soumyajitsahoo-cell/myuko/JOURNAL.md

---
title: "Myuko"
github: "https://github.com/soumyajitsahoo-cell/uncanny-cobweb"
description: "A custom made, music player, based on my own preferences. Listening to music with my long-screen phone just doesn't do it. I want a better experience, and I can't simply buy a music player because IT IS EXPENSIVE. I intend to have it run on android, with touchscreen support, and perhaps even finding songs like google does just with the sound of the song."
created_at: "2026-11-01"
total_time: "14h 24m"
---

# November 1, 2026: First Day, Brainstorming
<!-- fabricate:entry 1804 -->

I created my project in Fabricate. 
I really don't know where to start, so I'm still figuring it out
What I intend to make is quite difficult, to be honest
But with some research, I think i can do it
Today is my first day, I'll research the night to get a good grasp before starting in a non-directiona way



**Total time spent: 6m**

# November 2, 2026: Understood My Requirements and started designing
<!-- fabricate:entry 1835 -->

So, building a android-based music player and building the whole system seemed a bit unrealistic and a difficult achievement, so I'm lowering, just a bit. So, first, watched based music player. Aux support and Bluetooth, and runs via SD card. 
From what I researched, the Ingenious X1000E is a processor specifically for making music player(implemented in many market products) and using that is the best option so far. 
With that at it's center, I started designing the PCB designing, the core.
I haven't finished it(yet), and I'm working on it locally, not yet pushing to the git repo. Firstly it took me time to understand what I need to do, now I'm getting started at it

KiCad doesn't have the X1000E in-built in it's library, and I couldn't get it from EasyEDA because it had  a paywall in JLCPCB . Instead of paying or signing up for trials, I dug into the open-source community, extracted the official 190-ball BGA footprint (BGA-190_0.8mm) and schematic symbols, and manually injected them directly into my local KiCad project. Now, here is what I have done so far 
1]Connected a quartz crystal across pins R10 (EXCLK_XO) and T10 (EXCLK_XI) with two balanced 12pF load capacitors to ground.
2]an active-low reset on pin P6 (PPRST_) using a 10 kΩ pull-up resistor to +3V3 and a push-button to GND
3]tied the internal PLL analog and digital supplies (PLL_AVDD and PLL_DVDD) to a dedicated +1V2 rail, and anchored PLL_AVSS/PLL_DVSS to GND
4]Connected a 16MB Operating System Flash (W25Q128JVS), backed by a 0.1uF coupling capacitor
5] connected a 32-bit/384kHz DAC (TI PCM5102A) to the X1000E. Connections:
a) SA1_I2S_BCLK connected to Pin 13
b) SA2_I2S_LRCLK connected to Pin 15
c) SA4_I2S_DO connected Pin 14
Two hours in, the CPU core, system clock, OS memory bus, and the digital half of the audio subsystem are completely wired.
Next Steps:
1)Finish the PCM5102A analog filtering and 3.5mm Aux jack.
2)Add the MicroSD slot (where the FLAC/MP3 files will be stored).
3)Design the battery charging circuit (USB-C + PMIC).
4)Break out the display ribbon connector for the 1.28" circular screen.
Here are some screenshots from KiCad:




**Total time spent: 3h**

# November 3, 2026: Connected Headphone Jack,MicroSD Port, Processor Boot Config
<!-- fabricate:entry 2081 -->

So, in my last journal, I got started with the PCB design. Since then, I have made some progress(not much since I'm also busy with my classes). Here's what I did after my last journal
1] Completed the analog output stage of PCM5102A DAC and wired it to a 3.5mm Headphone Jack(I'm not mention the complete connections, but instead I'm providing screenshots so I don't have to type so much)(Wires were crossed between the DAC pins and the resistors to compensate for KiCad's jack symbol placing R above T, ensuring proper left/right stereo imaging in headphones.)
2] Connected Micro_SD_Card_Det(the symbol name) (Placed a No-Connect flag on Pin 9 to denote intentional floating card-detect switch without generating ERC warnings.)
3]Configured the Ingenic X1000E's internal bootloader state machine so that upon reset release, the processor fetches U-Boot and the Linux kernel directly from the external 16MB Flash (W25Q128JVS)

Next Steps: Connecting 1.28" Round Display. 
Below are images of my progress so far






I will upload the sch file once I'm done with it, I'm getting busy with the tests and classes that are happening. Once the weekend arrives, I'll sync my local folder to the project

**Total time spent: 2h 6m**

# November 7, 2026: Touch Display and USB C-Port Connection
<!-- fabricate:entry 2359 -->

So my streak is gone now, was busy with classes and labs, and Today I went to the theatres for a movie(it was absolutely fun and tiring too). Anyway, since my last journal, here are the changes I have made so far(screenshots will also be provided
below)
1]Display and Touch - Placed a 12-pin ribbon connector right above the MicroSD socket.
Powered the display logic and LED backlight with +3V3 and GND.
Connected all 5 picture lines directly to the top pins of the processor (U1).
Attached 4 touch name tags (TP_INT, TP_SDA, TP_SCL, TP_RST) so you can tap and swipe without running messy wires across the sheet.
2] USB-C port - Added the modern 16-pin USB-C receptacle.
Grounded the metal shell and ground pins to GND.
Added two independent 5.1kΩ resistors on CC1 and CC2 so smart USB-C chargers (like Apple or Anker) recognize the watch and provide 5V.
Labeled the incoming 5V line VBUS.
3] Battery Subsystem - Placed the MCP73831 charger chip powered by 5V VBUS with a 
4.7𝜇F smoothing capacitor.
Added a 4.7kΩ programming resistor (R8) to set a safe, gentle 212mA charging speed so the watch stays cool on your wrist.
Added a 2-pin battery plug (J5) and connected it to the master VBAT line.
4] Other - U5 (3.3V): Creates clean +3V3 for the screen, flash storage, SD card, and audio chip.
U6 (1.8V): Creates clean +1V8 for the brain's internal 64MB RAM.
U7 (1.2V): Creates clean +1V2 for the main CPU thinking engine.
Each regulator has its own input (1.0 μF) and output (2.2 μF) filter capacitors to keep voltages rock solid.
CPU Core: 8 pins of VDD wired together to +1V2.
Main Ground: 11 pins of VSS wired together to GND.
I/O Power: 4 pins of VDDIO wired together to +3V3.
RAM Memory Power: 6 pins of VSSMEM grounded; 6 pins of VDDMEM fed +1V8.
RAM Tuning Helpers: Added 0.1 μF capacitor (C15) on VREF0 and a precision 240Ω resistor (R9) on ZQ.
RAM Buffers & Core: 8 pins of LPDDR_VSS/Q tied to GND; 8 pins of LPDDR_VDD/Q tied to +1V8.
Unused JTAG Pins: Terminated 6 factory test pins at the bottom corner with blue X (No-Connect) flags.
Internal Codec: Powered its digital rails with +1V8 & GND, and marked all unused mic and speaker pins with blue X flags.

All the screenshots are given below




**Total time spent: 4h**

# November 9, 2026: Completed the PCB
<!-- fabricate:entry 2503 -->

Firstly, A late Happy Diwali to Everyone who is celebrating and knows about the festival. Stayed Eco-friendly, as I should, and had a lot of fun in the past few days. Today's the time to celebrate. 

With the help of my senior friend, Anshuman Pati, I was able to get my pcb design completed from the schematic I built( Basically he helped me get my PCB done from my schematic, huge thanks to him).

Now, the PCB is set to fit for a circular case of 23mm diameter, and is arranged properly. I'm going to update this repository and upload the files and bill of materials.

Screenshots of the 3D model of the PCB is given below. And By Today, or tomorrow, I will put everything in the repository, and take my time for building a readme.txt file. I'm on a clock now, since I have roughly 10-11 days to complete the whole thing and send a design review to get resources to build it

So excited for this, really. (Still haven't started with designing the UI :| )







**Total time spent: 5h 12m**
