soumyajitsahoo-cell/myuko/production/myuko_iso_3d.png

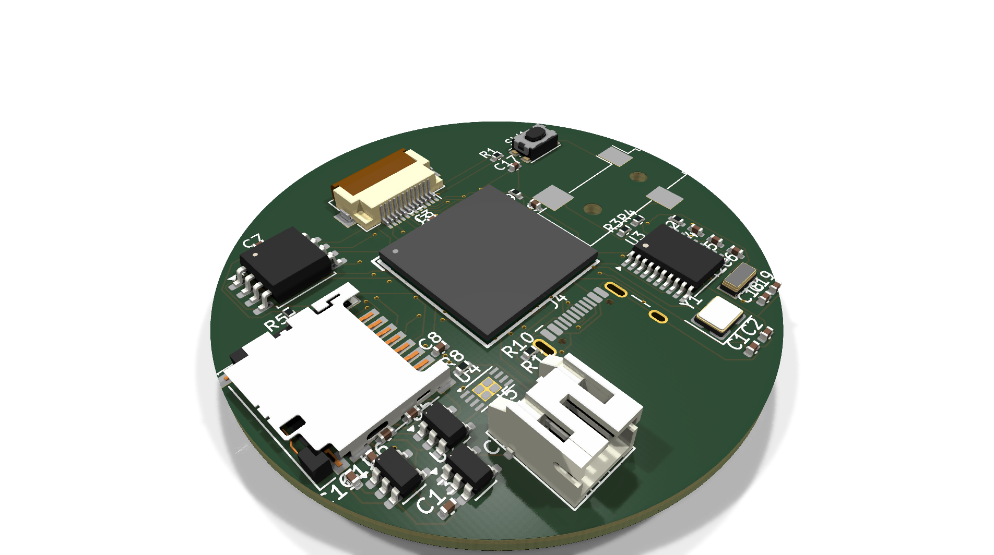
production/myuko_iso_3d.png
