soumyajitsahoo-cell/myuko/production/myuko_top_3d.png

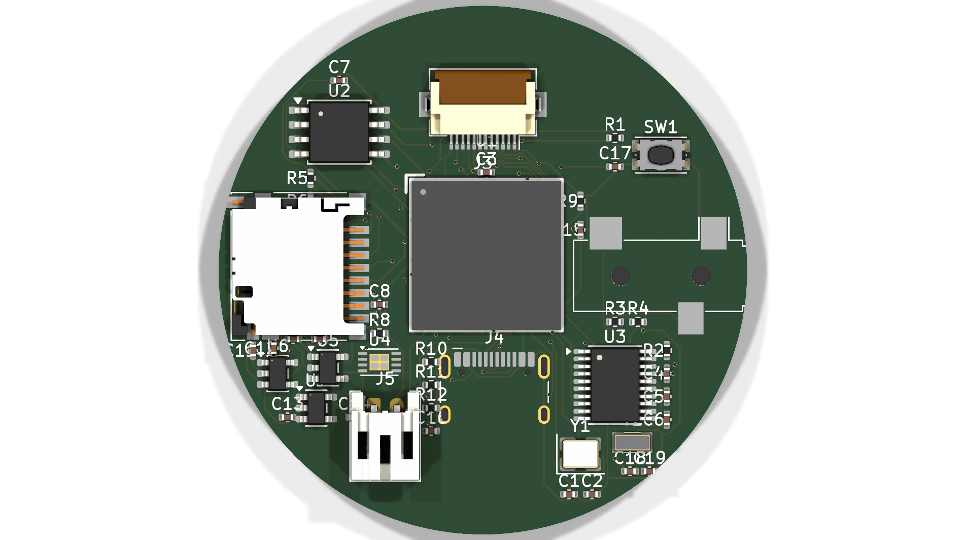
production/myuko_top_3d.png
