soumyajitsahoo-cell/myuko/production/watch_case/myuko_watch_all_black_iso.png

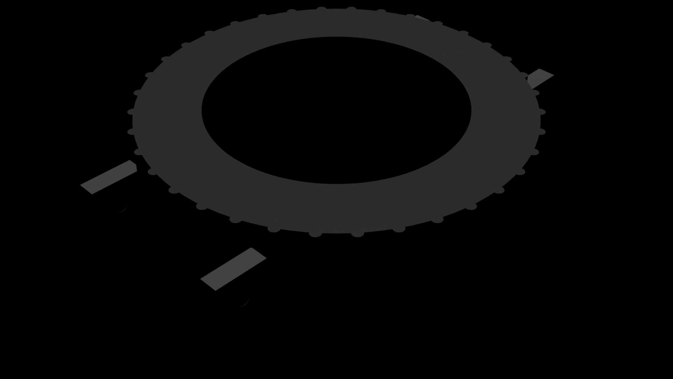
production/watch_case/myuko_watch_all_black_iso.png
