soumyajitsahoo-cell/myuko/production/watch_case/myuko_watch_all_black_top.png

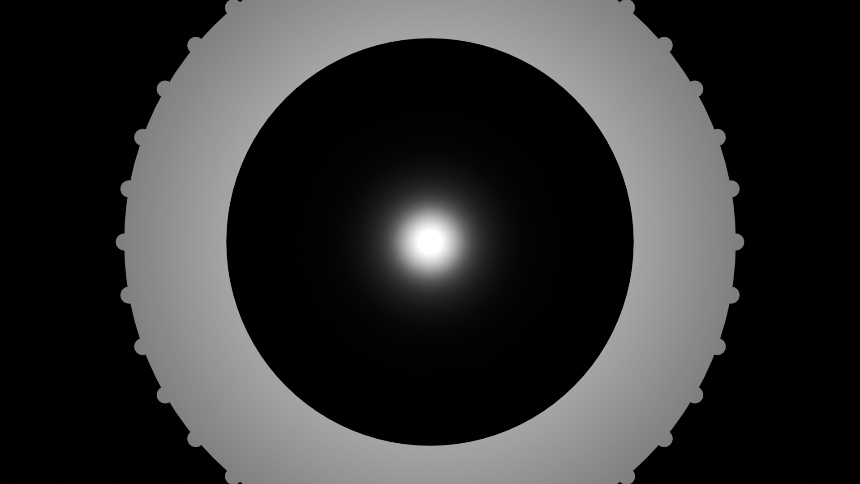
production/watch_case/myuko_watch_all_black_top.png
