soumyajitsahoo-cell/myuko/BOM.csv

Part | Type | Quantity | Unit price (USD) | Line total (USD) | Link | Vendor | Funding | Notes | Designator
Ingenic X1000E MIPS 1GHz CPU (64MB LPDDR) | Part | 1 | 5.80 | 5.80 | https://www.lcsc.com/product-detail/Microcontroller-Units-MCUs-MPUs-SOCs_Ingenic-Semicon-X1000E_C2689394.html | LCSC | Grant |  | U1
Winbond 16MB SPI NOR Flash (W25Q128) | Part | 1 | 0.85 | 0.85 | https://www.lcsc.com/product-detail/NOR-FLASH_Winbond-Elec-W25Q128JVSIQ_C97521.html | LCSC | Grant |  | U2
TI PCM5102APWR 32-bit 384kHz Audio DAC | Part | 1 | 2.10 | 2.10 | https://www.lcsc.com/product-detail/Audio-Power-OpAmps_Texas-Instruments-PCM5102APWR_C107671.html | LCSC | Grant |  | U3
Microchip MCP73831T Li-Po Charge IC | Part | 1 | 0.35 | 0.35 | https://www.lcsc.com/product-detail/Battery-Management-ICs_Microchip-Tech-MCP73831T-2ACI-MC_C49774.html | LCSC | Grant |  | U4
Diodes Inc AP2112K LDO Regulators (3.3V 1.8V 1.2V) | Part | 3 | 0.23 | 0.68 | https://www.lcsc.com/product-detail/Linear-Voltage-Regulators-LDO_Diodes-Incorporated-AP2112K-3-3TRG1_C51118.html | LCSC | Grant |  | U5 U6 U7
3.5mm Stereo Headphone Socket (SJ-3523-SMT) | Part | 1 | 0.25 | 0.25 | https://www.lcsc.com/product-detail/Audio-Connectors_CUI-Devices-SJ-3523-SMT-TR_C4991872.html | LCSC | Grant |  | J1
MicroSD Card Push-Push Push-Pull Socket | Part | 1 | 0.32 | 0.32 | https://www.lcsc.com/product-detail/Card-Sockets-Connectors_SOFNG-TF-01A_C2932349.html | LCSC | Grant |  | J2
FPC 0.5mm 12-Pin Top-Contact SMD Socket | Part | 1 | 0.18 | 0.18 | https://www.lcsc.com/product-detail/FFC-FPC-Connectors_JUSHUO-FPC0520HB-12P_C262657.html | LCSC | Grant |  | J3
USB Type-C 16-Pin Receptacle (USB 2.0 SMT) | Part | 1 | 0.28 | 0.28 | https://www.lcsc.com/product-detail/USB-Connectors_HOO-R-TYPE-C-16PIN-2MD-073_C2765186.html | LCSC | Grant |  | J4
JST-PH 2.0mm 2-Pin SMD Terminal | Part | 1 | 0.05 | 0.05 | https://www.lcsc.com/product-detail/Pluggable-System-Terminal-Block_JST-Sales-America-B2B-PH-K-S-LF-SN_C131337.html | LCSC | Grant |  | J5
Side SMD Tactile Switch 3x2.5mm | Part | 1 | 0.08 | 0.08 | https://www.lcsc.com/product-detail/Tactile-Switches_XKB-Enterprise-TS-1088R-02526_C2844781.html | LCSC | Grant |  | SW1
24MHz Main & 32.768kHz RTC Crystals (SMD 3225) | Part | 2 | 0.12 | 0.23 | https://www.lcsc.com/product-detail/Crystals_YXC-Yangxing-Tech-X322524MOB4SI_C70590.html | LCSC | Grant |  | Y1 Y2
0402 Ceramic Capacitors & Resistors (Assorted) | Part | 31 | 0.005 | 0.16 | https://www.lcsc.com/product-detail/Multilayer-Ceramic-Capacitors-MLCC-SMD-SMT_YAGEO-CC0402JRNPO9BN120_C1547.html | LCSC | Grant |  | C1-C19 R1-R12
1.28 inch Round IPS Touchscreen (GC9A01 + CST816S) | Part | 1 | 4.80 | 4.80 | https://www.waveshare.com/1.28inch-touch-lcd.htm | Waveshare Store | Grant |  | DISP1
3.7V 400mAh Li-Po Rechargeable Pouch Cell (502530) | Part | 1 | 3.50 | 3.50 | https://www.adafruit.com/product/1578 | Adafruit / Makerfabs | Grant |  | BAT1
20mm Quick-Release Black Silicone Sport Band | Part | 1 | 2.50 | 2.50 | https://www.amazon.com/dp/B07F2BF25S | Amazon / Retail | Grant |  | STRAP1
Custom 4-Layer Circular PCB (x5 boards fab cost) | PCB | 5 | 2.00 | 10.00 | https://jlcpcb.com | JLCPCB | Grant |  | PCB
4-Part Matte Black Nylon MJF Enclosure | 3D printed | 1 | 4.50 | 4.50 | https://jlcpcb.com/3d-printing | JLCPCB 3D Printing | Grant |  | CASE
Total |  |  |  | 36.63
