soumyajitsahoo-cell/myuko/production/bom_jlcpcb.csv

Comment | Designator | Footprint | LCSC Part #
12pF | C1,C2 | C_0402_1005Metric | C1547
0.1uF | C3,C5,C7,C15 | C_0402_1005Metric | C1525
2.2uF | C4,C6,C10,C12,C14 | C_0402_1005Metric | C23630
4.7uF | C8 | C_0402_1005Metric | C23633
1uF | C9,C11,C13,C16 | C_0402_1005Metric | C52923
1nF | C17 | C_0402_1005Metric | C1523
15pF | C18,C19 | C_0402_1005Metric | C1550
AudioJack3_Ground_Switch | J1 | Jack_3.5mm_CUI_SJ-3523-SMT_Horizontal | C4991872
Micro_SD_Card_Det1 | J2 | microSD_HC_Hirose_DM3D-SF | C381082
Conn_01x12_Pin | J3 | Hirose_FH12-12S-0.5SH_1x12-1MP_P0.50mm_Horizontal | C262661
USB_C_Receptacle_USB2.0_16P | J4 | USB_C_Receptacle_HCTL_HC-TYPE-C-16P-01A | C2765186
Conn_01x02_Pin | J5 | JST_PH_S2B-PH-K_1x02_P2.00mm_Horizontal | C131337
10k | R1,R2,R5,R6,R7 | R_0402_1005Metric | C25744
470 | R3,R4 | R_0402_1005Metric | C25117
4.7k | R8 | R_0402_1005Metric | C25900
240 | R9 | R_0402_1005Metric | C25091
5.1k | R10,R11 | R_0402_1005Metric | C25905
43.2 | R12 | R_0402_1005Metric | C25121
SW_Push | SW1 | SW_Push_1P1T_NO_CK_KMR2 | C318884
X1000 | U1 | BGA-190_L13.0-W13.0-R16-C16-P0.8-TR | C2689394
W25Q128JVS | U2 | SOIC-8_5.3x5.3mm_P1.27mm | C97521
PCM5102A | U3 | TSSOP-20_4.4x6.5mm_P0.65mm | C107671
MCP73831-2-MC | U4 | DFN-8-1EP_3x2mm_P0.5mm_EP1.7x1.4mm | C49774
AP2112K-3.3 | U5 | SOT-23-5 | C51118
AP2112K-1.8 | U6 | SOT-23-5 | C176944
AP2112K-1.2 | U7 | SOT-23-5 | C460310
Crystal | Y1 | Crystal_SMD_3225-4Pin_3.2x2.5mm | C70590
32.768kHz | Y2 | Crystal_SMD_3215-2Pin_3.2x1.5mm | C32346
