soumyajitsahoo-cell/myuko/production/watch_case/myuko_case_main_chassis.stl

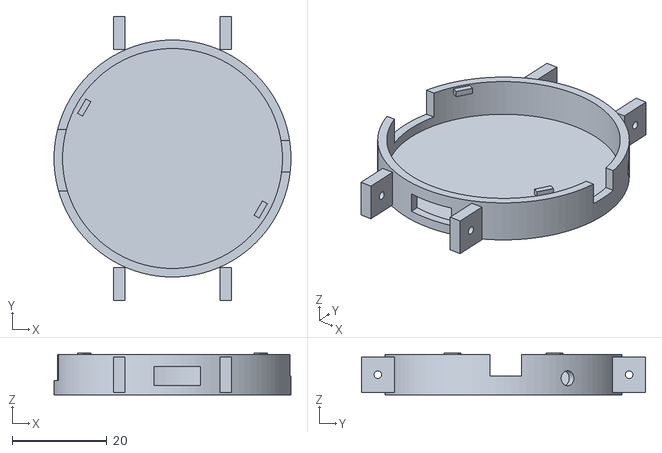
[picture p5: CAD file, 2026-11-09]
production/watch_case/myuko_case_main_chassis.stl
50.0 x 60.0 x 8.80
