soumyajitsahoo-cell/myuko/production/myuko_board.step

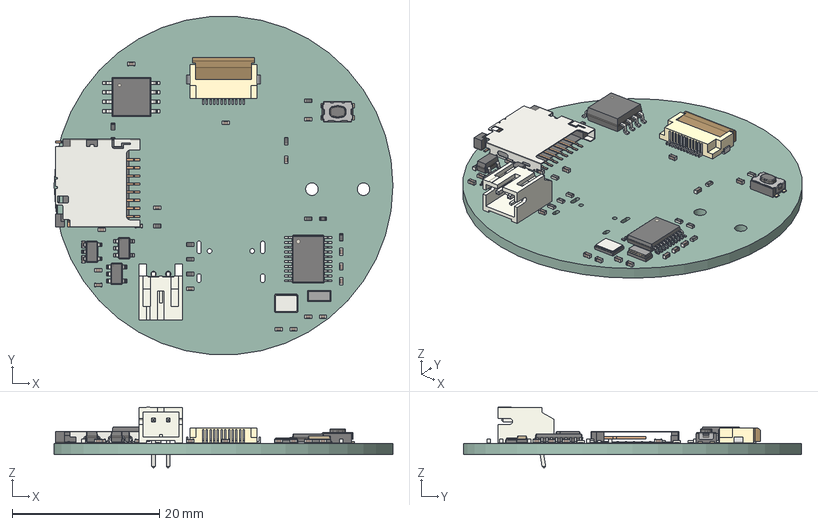
[picture p6: CAD file, 2026-11-09]
production/myuko_board.step
46.0 x 45.9 x 8.25 mm
SOT-23-5 x 3
C_0402_1005Metric x 19
lock
pins
R_0402_1005Metric x 12
SW_Push_1P1T_NO_CK_KMR2
microSD_HC_Hirose_DM3D-SF
Crystal_SMD_3215-2Pin_3.2x1.5mm
SOIC-8_5.3x5.3mm_P1.27mm
Crystal_SMD_3225-4Pin_3.2x2.5mm
JST_S2B_PH_K
TSSOP-20_4.4x6.5mm_P0.65mm
myuko_PCB
