soumyajitsahoo-cell/myuko/production/watch_case/myuko_case_back_cover.stl

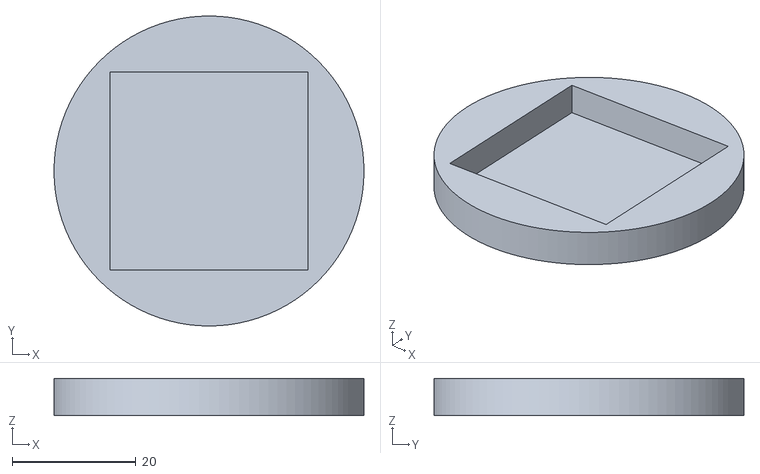
[picture p7: CAD file, 2026-11-09]
production/watch_case/myuko_case_back_cover.stl
50.0 x 50.0 x 6.00
