soumyajitsahoo-cell/myuko/production/watch_case/myuko_case_bezel_ring.stl

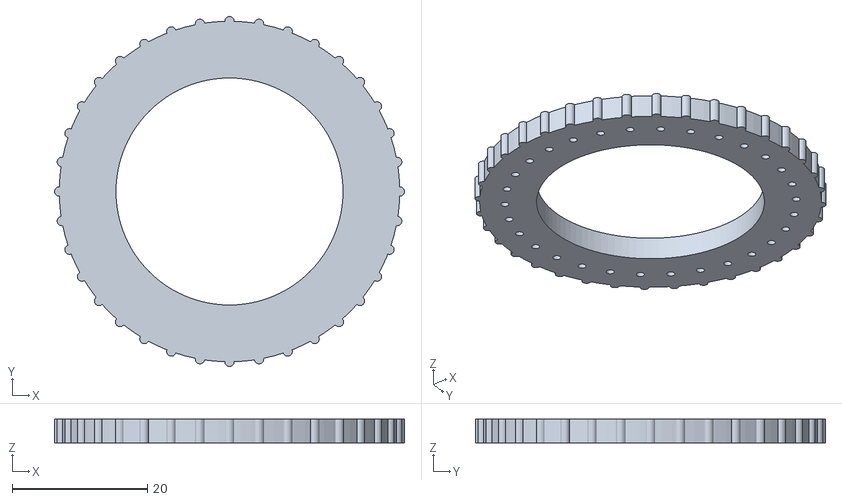
[picture p8: CAD file, 2026-11-09]
production/watch_case/myuko_case_bezel_ring.stl
51.8 x 51.8 x 3.50
