soumyajitsahoo-cell/myuko/production/watch_case/myuko_case_screen_bracket.stl

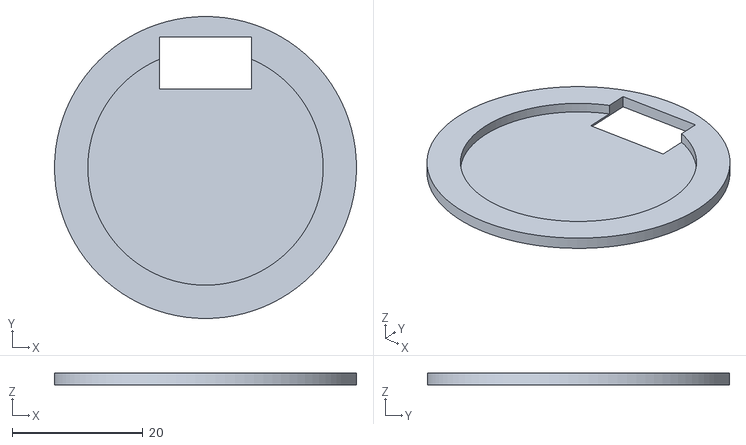
[picture p9: CAD file, 2026-11-09]
production/watch_case/myuko_case_screen_bracket.stl
46.2 x 46.2 x 1.80
