soumyajitsahoo-cell/myuko/(list of files, cad)

Other CAD files:
production/watch_case/myuko_watch_case.blend
