soumyajitsahoo-cell/myuko/myuko.kicad_pcb

## KiCad design myuko.kicad_pcb (2026-11-09)

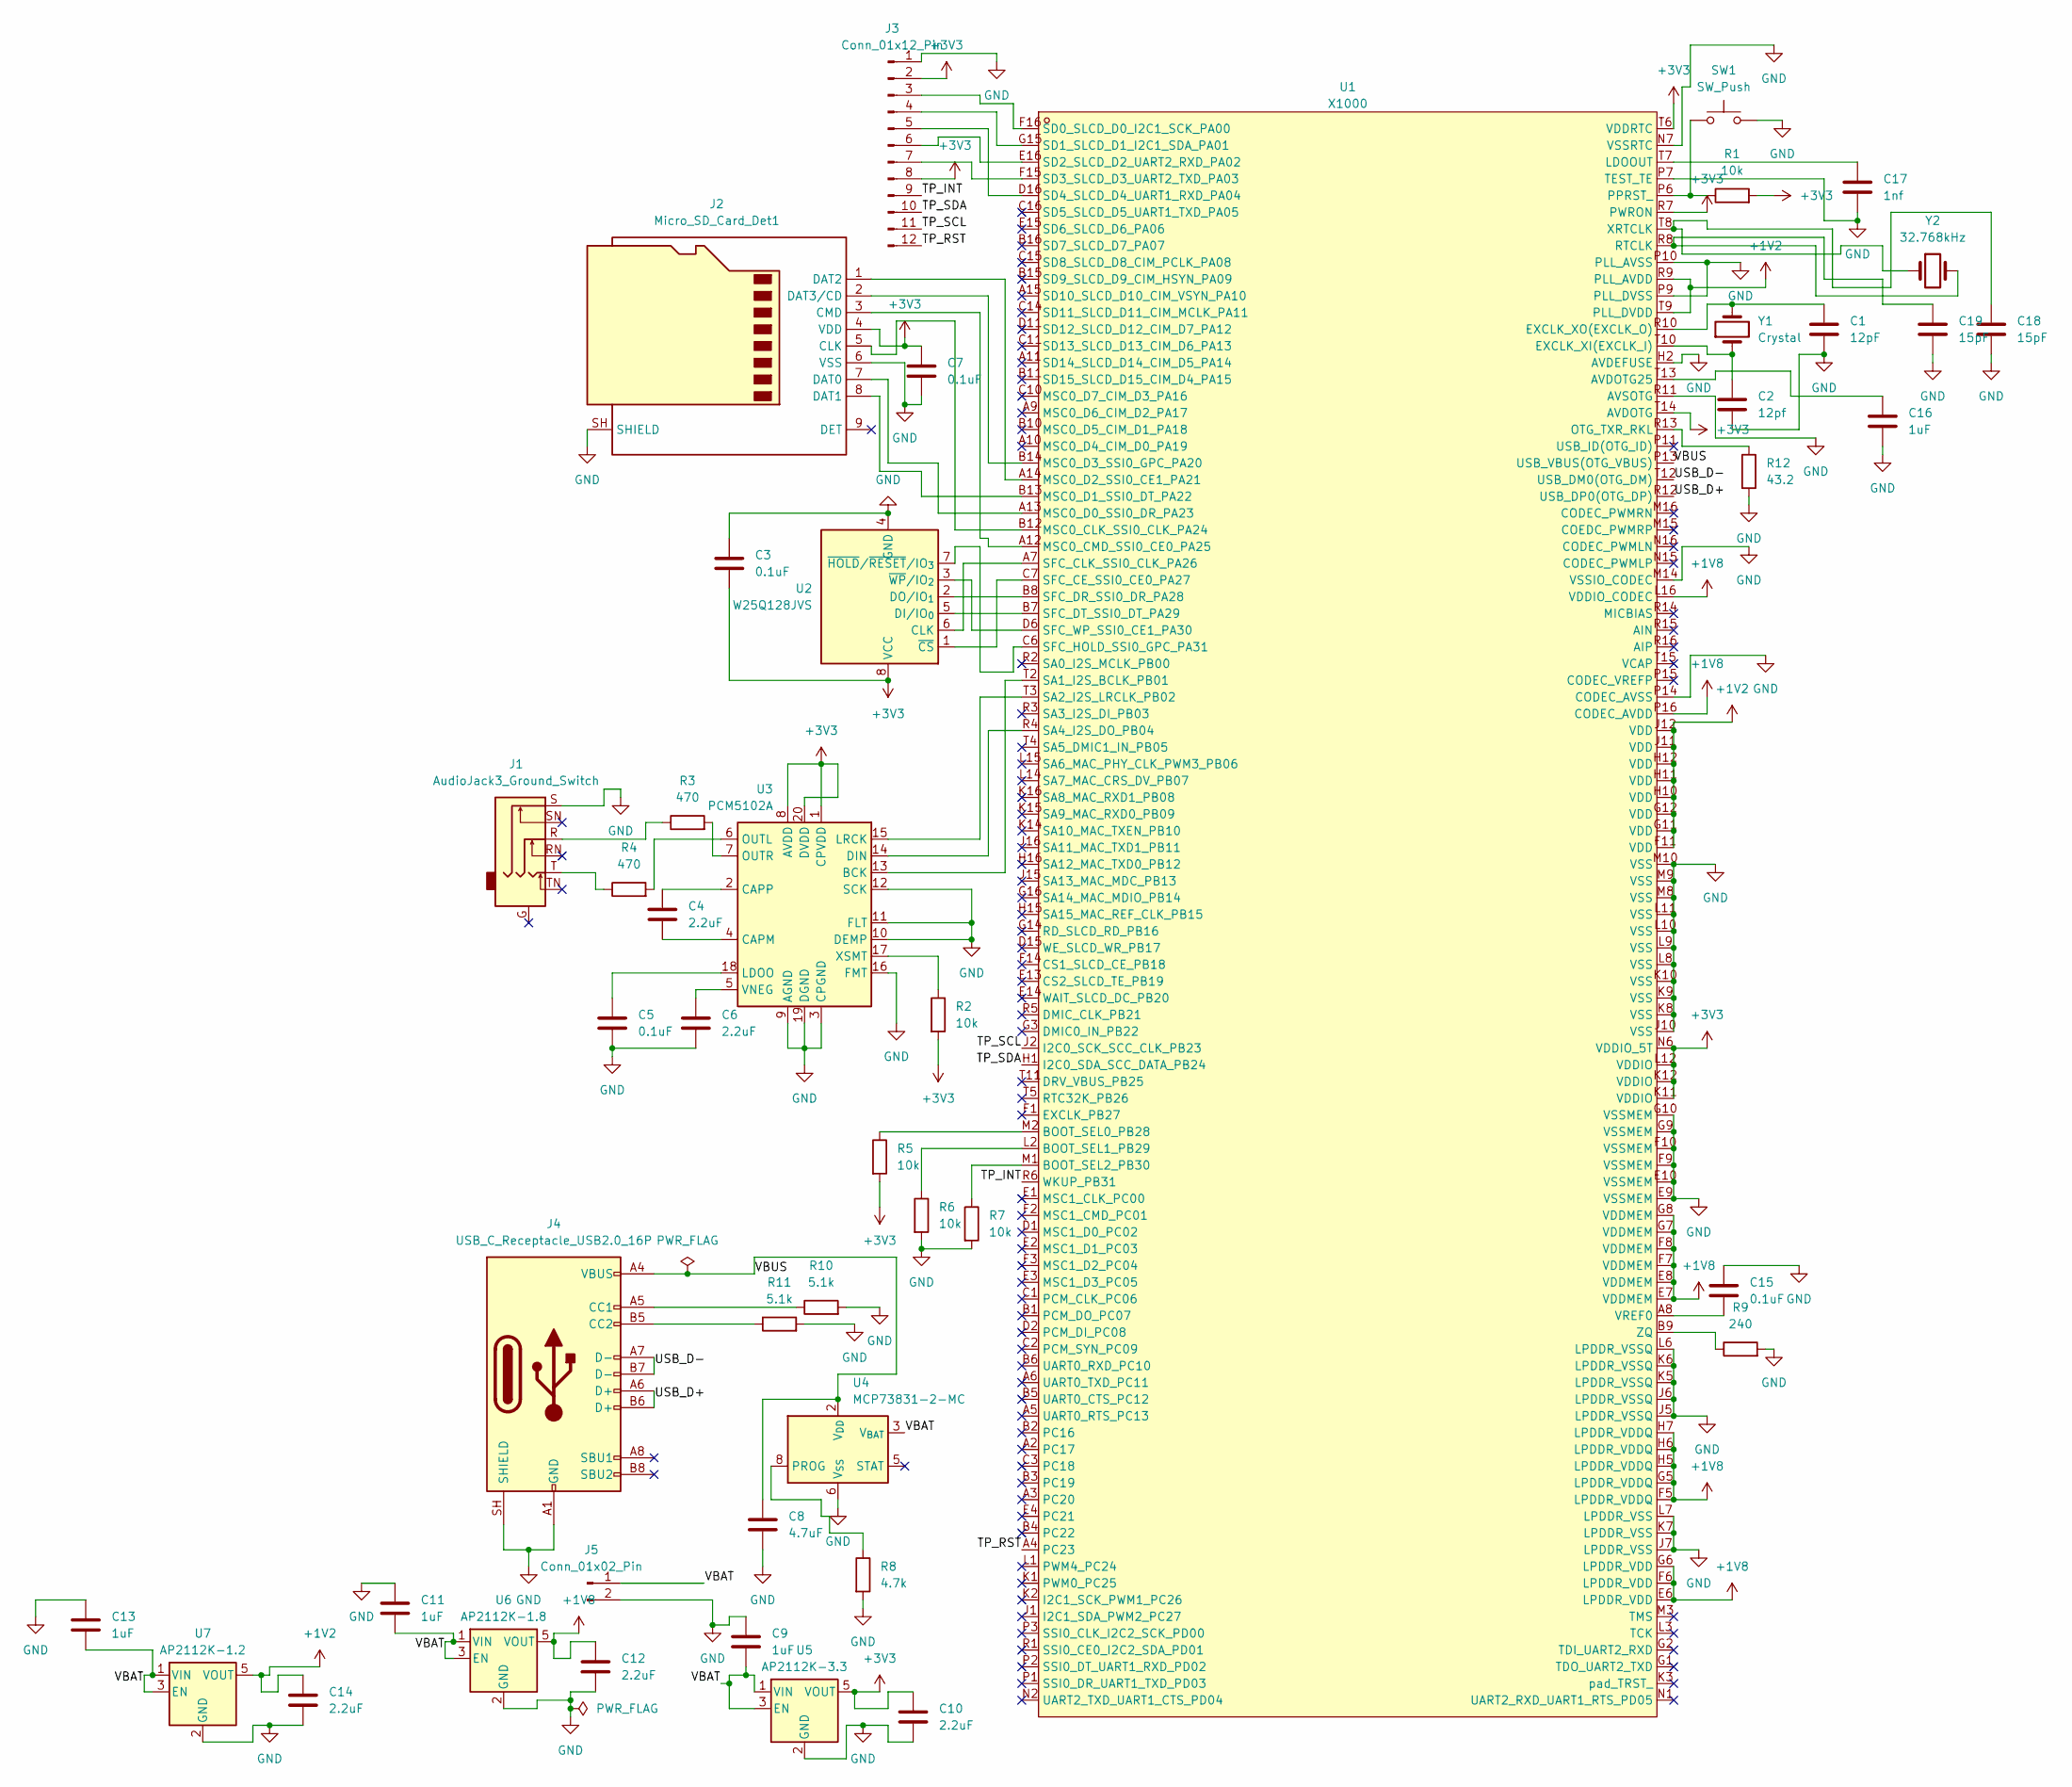
[picture p10: schematic myuko.kicad_sch, Design for myuko watch]

Parts:
C1: 12pF; C_0402_1005Metric
C2: 12pf; C_0402_1005Metric
C3, C5, C7, C15: 0.1uF; C_0402_1005Metric
C4, C6, C10, C12, C14: 2.2uF; C_0402_1005Metric
C8: 4.7uF; C_0402_1005Metric
C9, C11, C13, C16: 1uF; C_0402_1005Metric
C17: 1nf; C_0402_1005Metric
C18, C19: 15pF; C_0402_1005Metric
J1: AudioJack3_Ground_Switch; Jack_3.5mm_CUI_SJ-3523-SMT_Horizontal
J2: Micro_SD_Card_Det1; microSD_HC_Hirose_DM3D-SF
J3: Conn_01x12_Pin; Hirose_FH12-12S-0.5SH_1x12-1MP_P0.50mm_Horizontal
J4: USB_C_Receptacle_USB2.0_16P; USB_C_Receptacle_HCTL_HC-TYPE-C-16P-01A
J5: Conn_01x02_Pin; JST_PH_S2B-PH-K_1x02_P2.00mm_Horizontal
R1, R2, R5, R6, R7: 10k; R_0402_1005Metric
R3, R4: 470; R_0402_1005Metric
R8: 4.7k; R_0402_1005Metric
R9: 240; R_0402_1005Metric
R10, R11: 5.1k; R_0402_1005Metric
R12: 43.2; R_0402_1005Metric
SW1: SW_Push; SW_Push_1P1T_NO_CK_KMR2
U1: X1000; BGA-190_L13.0-W13.0-R16-C16-P0.8-TR; MPN X1000; LCSC Part C2689394
U2: W25Q128JVS; SOIC-8_5.3x5.3mm_P1.27mm
U3: PCM5102A; TSSOP-20_4.4x6.5mm_P0.65mm
U4: MCP73831-2-MC; DFN-8-1EP_3x2mm_P0.5mm_EP1.7x1.4mm
U5: AP2112K-3.3; SOT-23-5
U6: AP2112K-1.8; SOT-23-5
U7: AP2112K-1.2; SOT-23-5
Y1: Crystal; Crystal_SMD_3225-4Pin_3.2x2.5mm
Y2: 32.768kHz; Crystal_SMD_3215-2Pin_3.2x1.5mm

Connections:
+1V2: C14.1, U1.F11 (VDD), U1.G11 (VDD), U1.G12 (VDD), U1.H10 (VDD), U1.H11 (VDD), U1.H12 (VDD), U1.J11 (VDD), U1.J12 (VDD), U1.R9 (PLL_AVDD), U1.T9 (PLL_DVDD), U7.5 (VOUT)
+1V8: C12.1, U1.E6 (LPDDR_VDD), U1.E7 (VDDMEM), U1.E8 (VDDMEM), U1.F5 (LPDDR_VDDQ), U1.F6 (LPDDR_VDD), U1.F7 (VDDMEM), U1.F8 (VDDMEM), U1.G5 (LPDDR_VDDQ), U1.G6 (LPDDR_VDD), U1.G7 (VDDMEM), U1.G8 (VDDMEM), U1.H5 (LPDDR_VDDQ), U1.H6 (LPDDR_VDDQ), U1.H7 (LPDDR_VDDQ), U1.L16 (VDDIO_CODEC), U1.P16 (CODEC_AVDD), U6.5 (VOUT)
+3V3: C3.1, C7.1, C10.1, J2.4 (VDD), J3.2, J3.8, R1.2, R2.2, R5.2, U1.K11 (VDDIO), U1.K12 (VDDIO), U1.L12 (VDDIO), U1.N6 (VDDIO_5T), U1.R7 (PWRON), U1.T6 (VDDRTC), U1.T14 (AVDOTG), U2.8 (VCC), U3.1 (CPVDD), U3.8 (AVDD), U3.20 (DVDD), U5.5 (VOUT)
/TP_INT: J3.9, U1.R6 (WKUP_PB31)
/TP_RST: J3.12, U1.A4 (PC23)
/TP_SCL: J3.11, U1.J2 (I2C0_SCK_SCC_CLK_PB23)
/TP_SDA: J3.10, U1.H1 (I2C0_SDA_SCC_DATA_PB24)
/USB_D+: J4.A6 (D+), J4.B6 (D+), U1.R12 (USB_DP0(OTG_DP))
/USB_D-: J4.A7 (D-), J4.B7 (D-), U1.T12 (USB_DM0(OTG_DM))
/VBAT: C9.2, C11.2, C13.2, J5.1, U4.3 (V_{BAT}), U4.4 (V_{BAT}), U5.1 (VIN), U5.3 (EN), U6.1 (VIN), U6.3 (EN), U7.1 (VIN), U7.3 (EN)
/VBUS: C8.1, J4.A4 (VBUS), J4.A9 (VBUS), J4.B4 (VBUS), J4.B9 (VBUS), U1.P13 (USB_VBUS(OTG_VBUS)), U4.1 (V_{DD}), U4.2 (V_{DD})
GND: C1.2, C2.2, C3.2, C5.2, C6.2, C7.2, C8.2, C9.1, C10.2, C11.1, C12.2, C13.1, C14.2, C15.1, C16.2, C17.2, C18.2, C19.2, J1.S, J2.6 (VSS), J2.SH (SHIELD), J3.1, J4.A1 (GND), J4.A12 (GND), J4.B1 (GND), J4.B12 (GND), J4.SH (SHIELD), J5.2, R6.2, R7.2, R8.2, R9.2, R10.2, R11.2, R12.2, SW1.2, U1.E9 (VSSMEM), U1.E10 (VSSMEM), U1.F9 (VSSMEM), U1.F10 (VSSMEM), U1.G9 (VSSMEM), U1.G10 (VSSMEM), U1.H2 (AVDEFUSE), U1.J5 (LPDDR_VSSQ), U1.J6 (LPDDR_VSSQ), U1.J7 (LPDDR_VSS), U1.J10 (VSS), U1.K5 (LPDDR_VSSQ), U1.K6 (LPDDR_VSSQ), U1.K7 (LPDDR_VSS), U1.K8 (VSS), U1.K9 (VSS), U1.K10 (VSS), U1.L6 (LPDDR_VSSQ), U1.L7 (LPDDR_VSS), U1.L8 (VSS), U1.L9 (VSS), U1.L10 (VSS), U1.L11 (VSS), U1.M8 (VSS), U1.M9 (VSS), U1.M10 (VSS), U1.M14 (VSSIO_CODEC), U1.N7 (VSSRTC), U1.P7 (TEST_TE), U1.P9 (PLL_DVSS), U1.P10 (PLL_AVSS), U1.P14 (CODEC_AVSS), U1.R11 (AVSOTG), U2.4 (GND), U3.3 (CPGND), U3.9 (AGND), U3.10 (DEMP), U3.11 (FLT), U3.12 (SCK), U3.16 (FMT), U3.19 (DGND), U4.6 (V_{SS}), U5.2 (GND), U6.2 (GND), U7.2 (GND)
unnamed: J1.R, R3.1
unnamed: J1.T, R4.1
unnamed: J2.5 (CLK), U1.B12 (MSC0_CLK_SSI0_CLK_PA24)
unnamed: J2.3 (CMD), U1.A12 (MSC0_CMD_SSI0_CE0_PA25)
unnamed: J2.7 (DAT0), U1.A13 (MSC0_D0_SSI0_DR_PA23)
unnamed: J2.8 (DAT1), U1.B13 (MSC0_D1_SSI0_DT_PA22)
unnamed: J2.1 (DAT2), U1.A14 (MSC0_D2_SSI0_CE1_PA21)
unnamed: J2.2 (DAT3/CD), U1.B14 (MSC0_D3_SSI0_GPC_PA20)
unnamed: J3.3, U1.F16 (SD0_SLCD_D0_I2C1_SCK_PA00)
unnamed: J3.4, U1.G15 (SD1_SLCD_D1_I2C1_SDA_PA01)
unnamed: J3.5, U1.D16 (SD4_SLCD_D4_UART1_RXD_PA04)
unnamed: J3.6, U1.E16 (SD2_SLCD_D2_UART2_RXD_PA02)
unnamed: J3.7, U1.F15 (SD3_SLCD_D3_UART2_TXD_PA03)
unnamed: J4.A5 (CC1), R10.1
unnamed: J4.B5 (CC2), R11.1
unnamed: C16.1, U1.T13 (AVDOTG25)
unnamed: R5.1, U1.M2 (BOOT_SEL0_PB28)
unnamed: R6.1, U1.L2 (BOOT_SEL1_PB29)
unnamed: R7.1, U1.M1 (BOOT_SEL2_PB30)
unnamed: C2.1, U1.T10 (EXCLK_XI(EXCLK_I)), Y1.1
unnamed: C1.1, U1.R10 (EXCLK_XO(EXCLK_O)), Y1.2
unnamed: C17.1, U1.T7 (LDOOUT)
unnamed: R12.1, U1.R13 (OTG_TXR_RKL)
unnamed: R1.1, SW1.1, U1.P6 (PPRST_)
unnamed: C19.1, U1.R8 (RTCLK), Y2.2
unnamed: U1.T2 (SA1_I2S_BCLK_PB01), U3.13 (BCK)
unnamed: U1.T3 (SA2_I2S_LRCLK_PB02), U3.15 (LRCK)
unnamed: U1.R4 (SA4_I2S_DO_PB04), U3.14 (DIN)
unnamed: U1.C7 (SFC_CE_SSI0_CE0_PA27), U2.1 (~CS)
unnamed: U1.A7 (SFC_CLK_SSI0_CLK_PA26), U2.6 (CLK)
unnamed: U1.B8 (SFC_DR_SSI0_DR_PA28), U2.2 (DO/IO_{1})
unnamed: U1.B7 (SFC_DT_SSI0_DT_PA29), U2.5 (DI/IO_{0})
unnamed: U1.C6 (SFC_HOLD_SSI0_GPC_PA31), U2.7 (~HOLD/~RESET/IO_{3})
unnamed: U1.D6 (SFC_WP_SSI0_CE1_PA30), U2.3 (~WP/IO_{2})
unnamed: C15.2, U1.A8 (VREF0)
unnamed: C18.1, U1.T8 (XRTCLK), Y2.1
unnamed: R9.1, U1.B9 (ZQ)
unnamed: C4.2, U3.4 (CAPM)
unnamed: C4.1, U3.2 (CAPP)
unnamed: C5.1, U3.18 (LDOO)
unnamed: R4.2, U3.6 (OUTL)
unnamed: R3.2, U3.7 (OUTR)
unnamed: C6.1, U3.5 (VNEG)
unnamed: R2.1, U3.17 (XSMT)
unnamed: R8.1, U4.8 (PROG)

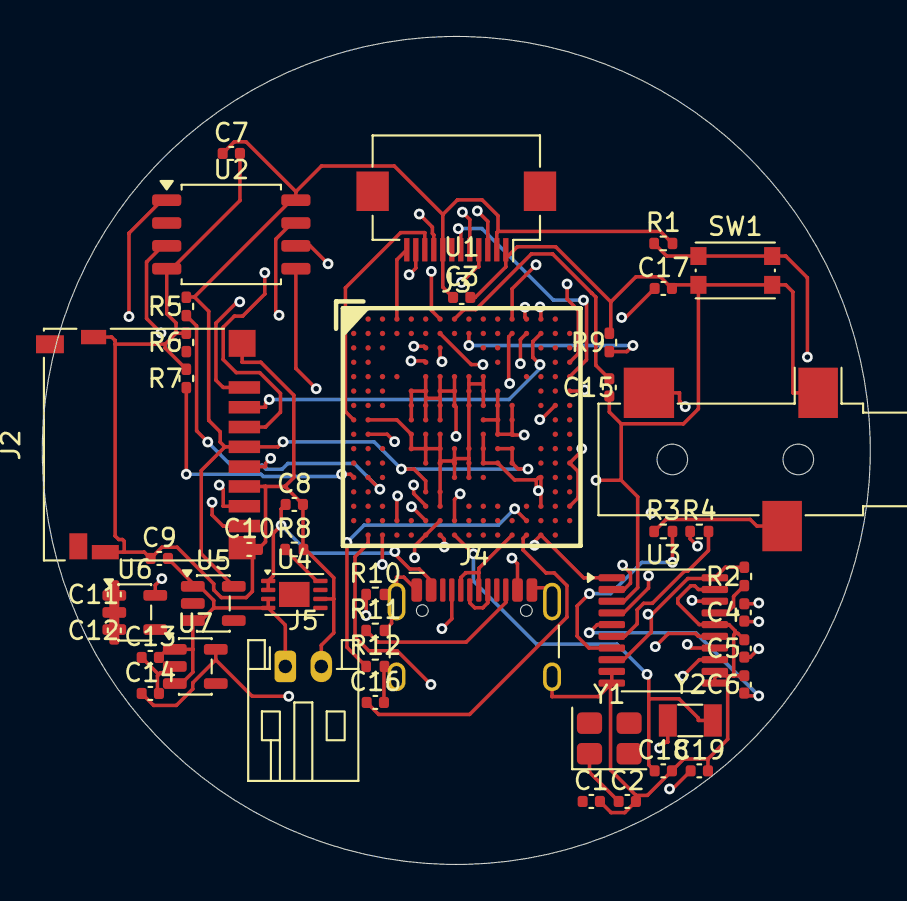
[picture p11: board myuko.kicad_pcb from above]

Board: 4 copper layers, 46.0 x 46.0 mm, 46 parts (0 on the bottom side), 57 nets.
