soumyajitsahoo-cell/myuko/(commit log)

2026-11-02 Revise project description and add design notes
    Updated project details and added initial brainstorming and design notes for the custom Android-based music player. Included technical specifications and progress on PCB design.
2026-11-09 Update total time and add PCB completion entry
    Updated total time spent and added a new entry about completing the PCB design, including details on collaboration and future plans.
2026-11-09 Add BOM with component details and pricing
    Added bill of materials with details for components including part numbers, prices, and links.
    [BOM.csv]
2026-11-09 Uploading all the project files from local to github repo for design review
    [bom_fabricate_hackclub.csv, bom_jlcpcb.csv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]
2026-11-09 Revise BOM with new components and pricing
    Updated BOM with new parts and adjusted quantities and prices.
    [BOM.csv]
